asdrubalfuentes/ayModbusConverter/hardware/netlist.csv

Red | Nodos
+5V | J2.12 / U1.3 / C1.1 / C3.1 / U2.8
+VIN | J1.3 / U1.1 / C2.1
GND | J1.4 / J2.2 / J2.9 / J2.11 / J3.1 / J3.10 / U1.2 / C2.2 / C1.2 / C3.2 / U2.5 / R3.2 / D1.2
LED_A | R4.2 / D1.1
LED_D | J3.2 / R4.1
P1_DE | J2.6 / U2.2 / U2.3
P1_DI | J2.8 / U2.4
P1_RO | J2.7 / R2.2 / R3.1
RO_RAW | U2.1 / R2.1
RS485_A | J1.1 / U2.6 / R1.2
RS485_B | J1.2 / U2.7 / R1.1
