asdrubalfuentes/ayModbusConverter/hardware/enclosure/pieza1_chasis_desarrollo.dxf

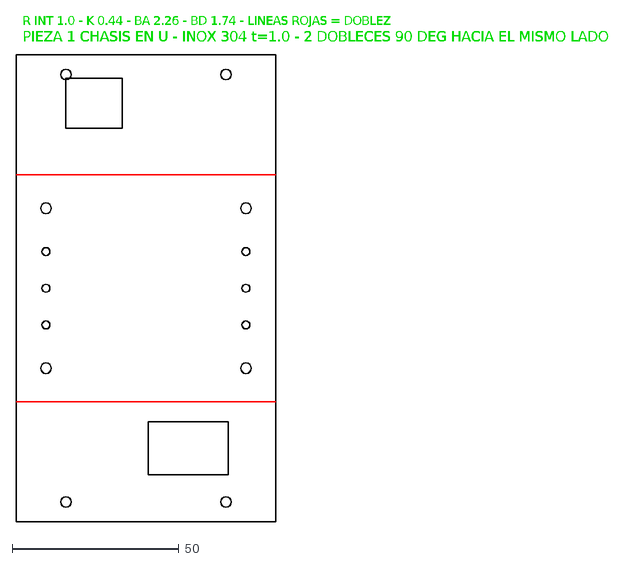
[picture p3: CAD file, 2026-11-12]
hardware/enclosure/pieza1_chasis_desarrollo.dxf
PIEZA 1 CHASIS EN U - INOX 304 t=1.0 - 2 DOBLECES 90 DEG HACIA EL MISMO LADO
R INT 1.0 - K 0.44 - BA 2.26 - BD 1.74 - LINEAS ROJAS = DOBLEZ
