asdrubalfuentes/ayModbusConverter/hardware/enclosure/pieza2_tapa_desarrollo.dxf

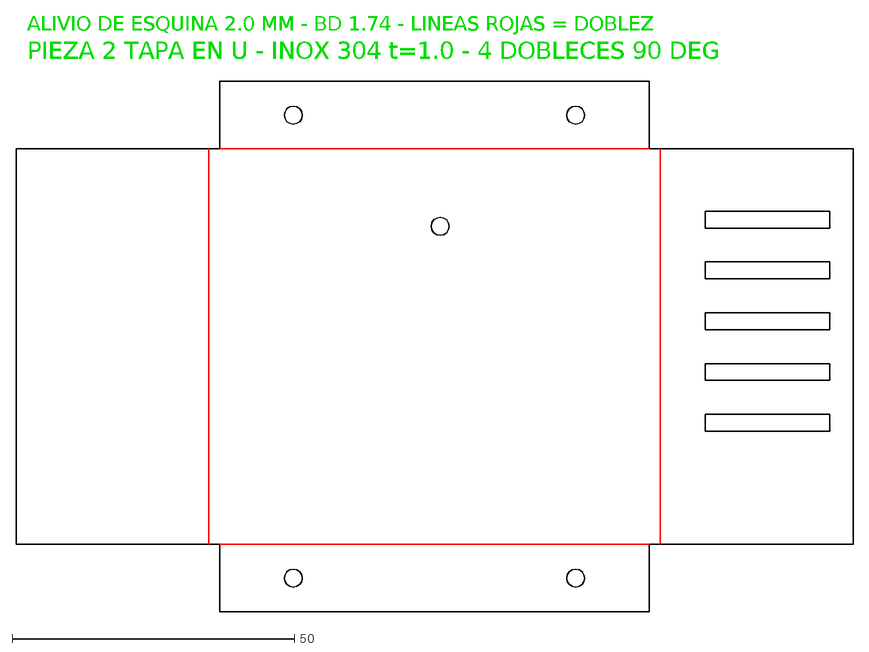
[picture p4: CAD file, 2026-11-12]
hardware/enclosure/pieza2_tapa_desarrollo.dxf
PIEZA 2 TAPA EN U - INOX 304 t=1.0 - 4 DOBLECES 90 DEG
ALIVIO DE ESQUINA 2.0 MM - BD 1.74 - LINEAS ROJAS = DOBLEZ
