asdrubalfuentes/ayModbusConverter/hardware/aymc_carrier_min.kicad_pcb

## KiCad design hardware/aymc_carrier_min.kicad_pcb (2026-11-12)

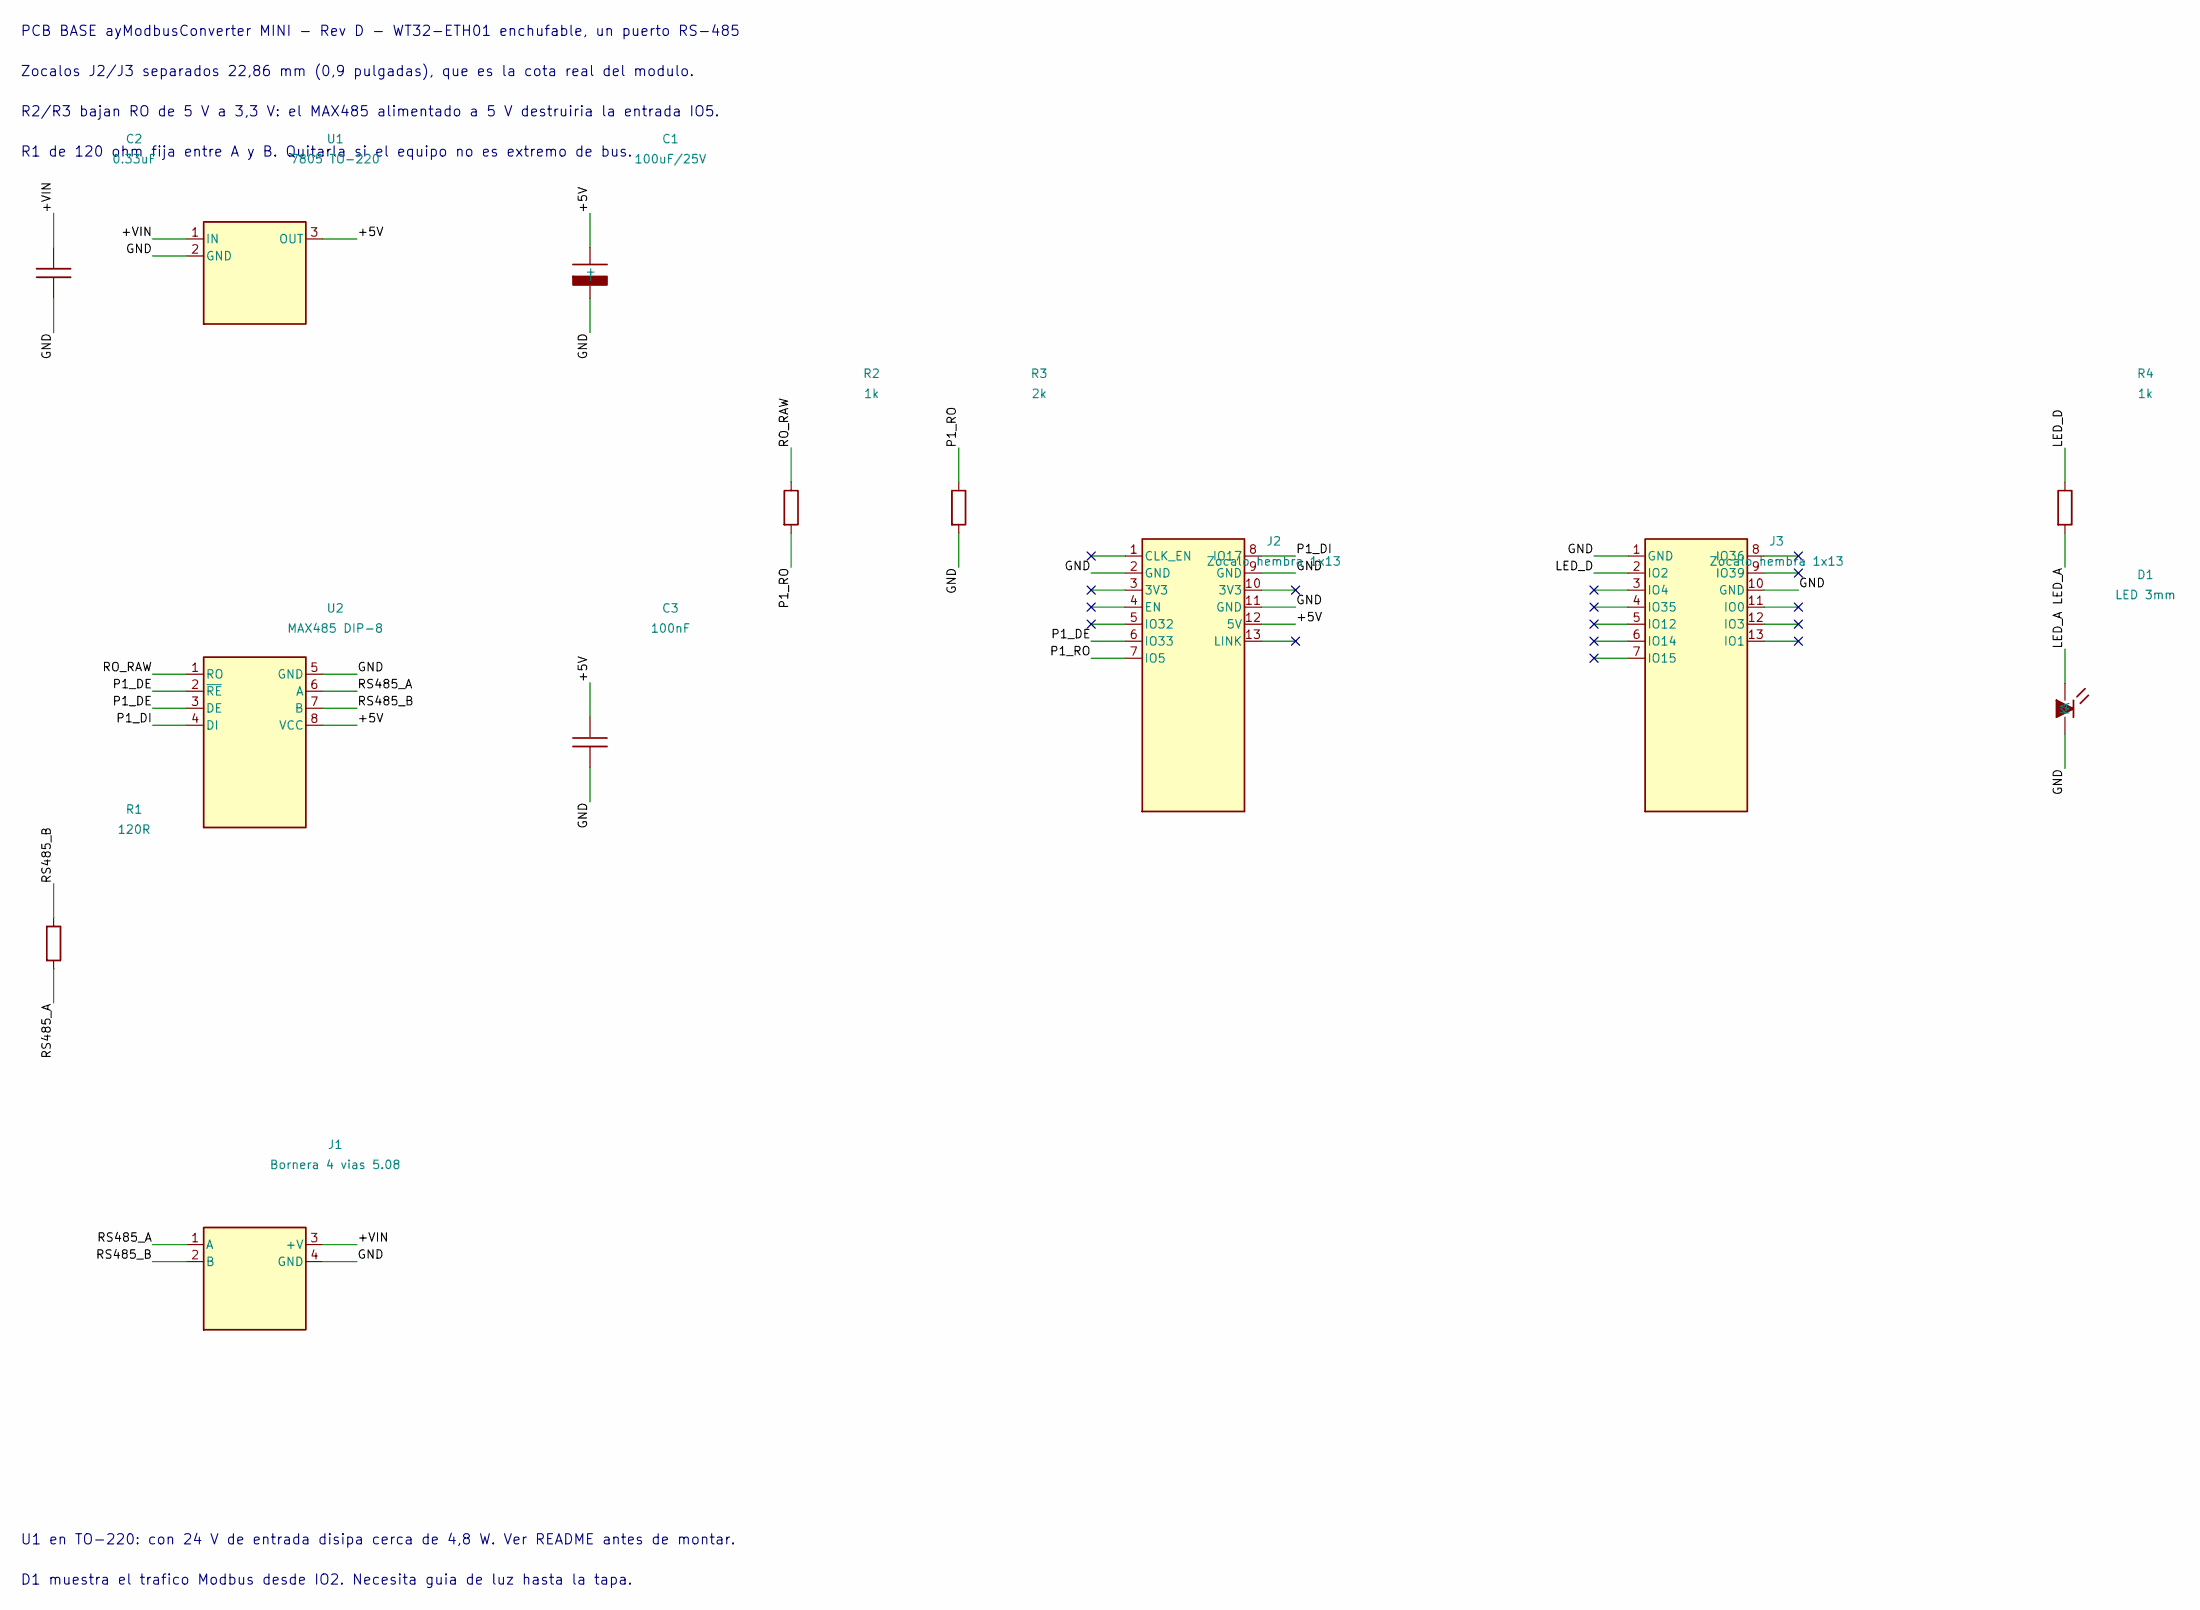
[picture p5: schematic aymc_carrier_min.kicad_sch, PCB base ayModbusConverter MINI]

Parts:
C1: 100uF/25V
C2: 0.33uF
C3: 100nF
D1: LED 3mm
J1: Bornera 4 vias 5.08
J2, J3: Zocalo hembra 1x13
R1: 120R
R2, R4: 1k
R3: 2k
U1: 7805 TO-220
U2: MAX485 DIP-8

Connections:
+5V: C1.1 (+), C3.1, J2.12 (5V), U1.3 (OUT), U2.8 (VCC)
+VIN: C2.1, J1.3 (+V), U1.1 (IN)
GND: C1.2 (-), C2.2, C3.2, D1.2 (K), J1.4 (GND), J2.2 (GND), J2.9 (GND), J2.11 (GND), J3.1 (GND), J3.10 (GND), R3.2, U1.2 (GND), U2.5 (GND)
LED_A: D1.1 (A), R4.2
LED_D: J3.2 (IO2), R4.1
P1_DE: J2.6 (IO33), U2.2 (~RE), U2.3 (DE)
P1_DI: J2.8 (IO17), U2.4 (DI)
P1_RO: J2.7 (IO5), R2.2, R3.1
RO_RAW: R2.1, U2.1 (RO)
RS485_A: J1.1 (A), R1.2, U2.6 (A)
RS485_B: J1.2 (B), R1.1, U2.7 (B)

Notes on the sheet:
PCB BASE ayModbusConverter MINI - Rev D - WT32-ETH01 enchufable, un puerto RS-485
Zocalos J2/J3 separados 22,86 mm (0,9 pulgadas), que es la cota real del modulo.
R2/R3 bajan RO de 5 V a 3,3 V: el MAX485 alimentado a 5 V destruiria la entrada IO5.
R1 de 120 ohm fija entre A y B. Quitarla si el equipo no es extremo de bus.
U1 en TO-220: con 24 V de entrada disipa cerca de 4,8 W. Ver README antes de montar.
D1 muestra el trafico Modbus desde IO2. Necesita guia de luz hasta la tapa.

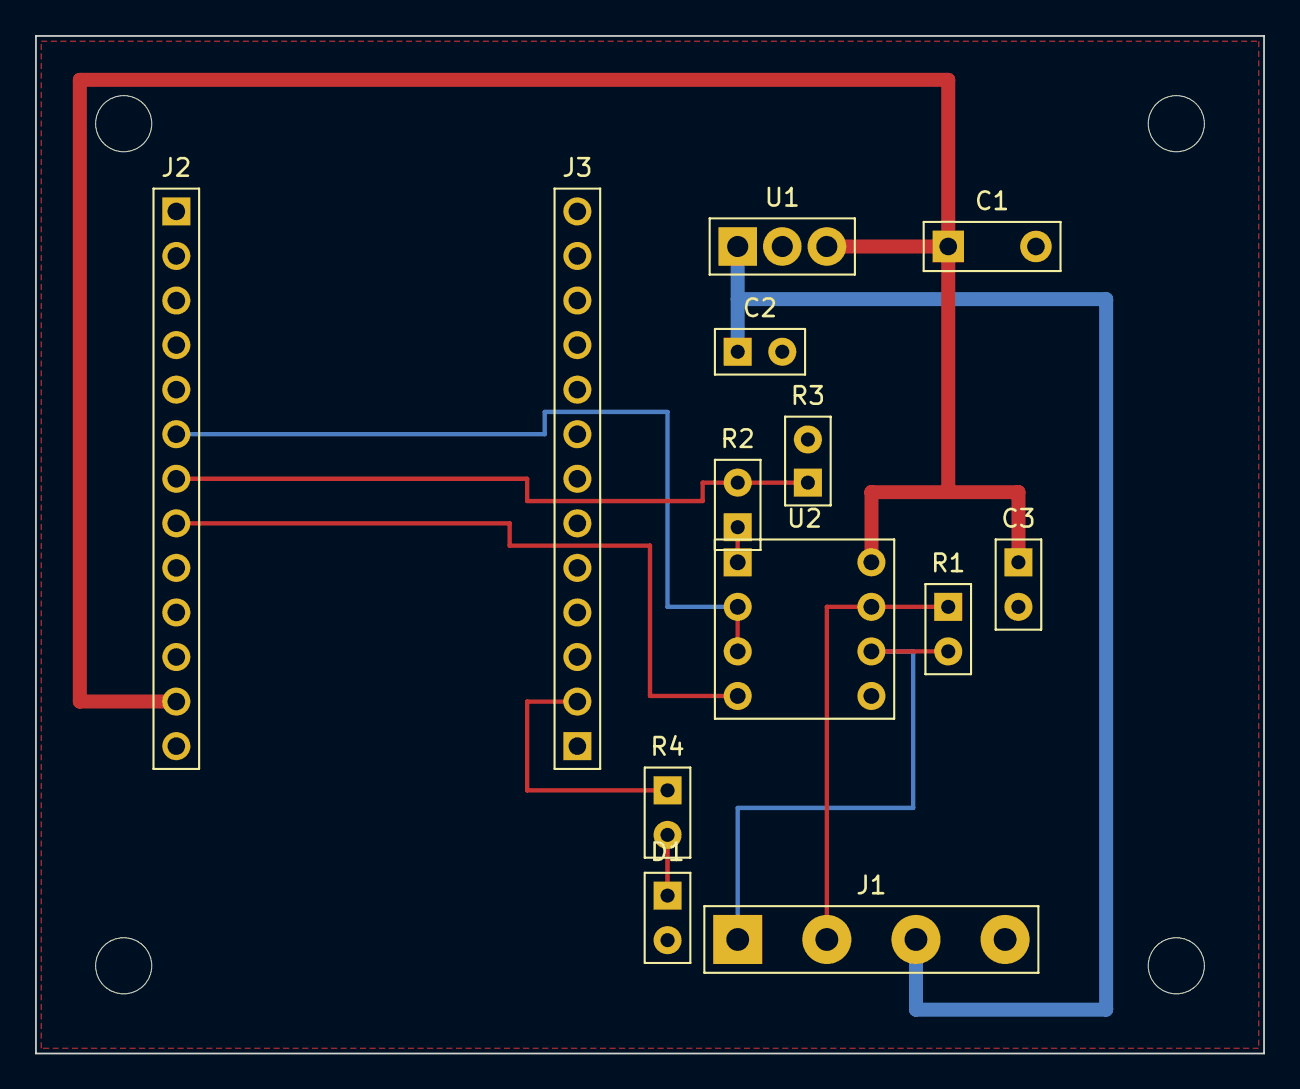
[picture p6: board aymc_carrier_min.kicad_pcb from above]

Board: 2 copper layers, 70.0 x 58.0 mm, 13 parts (0 on the bottom side), 11 nets.
