asdrubalfuentes/ayModbusConverter/(commit log)

2026-09-28 ayModbusConverter 1.0.0: conversor Modbus TCP <-> RTU sobre WT32-ETH01
    Servidor Modbus TCP transparente hacia el bus RS-485, LAN con DHCP/IP fija,
    WiFi solo como AP con portal cautivo, web de configuracion y diagnostico,
    OLED 128x64, OTA web y desde GitHub Releases.
2026-09-28 Banco de pruebas: simulador de esclavos RTU y bateria automatica
    - test/tools/rtu_slave_sim.py: esclavos Modbus RTU multi-ID con datos
    deterministas y retardo configurable por esclavo.
    - test/tools/gw_test.py: 18 pruebas de extremo a extremo por Modbus TCP
    (funciones, excepciones, TID/UID, encadenadas, fragmentadas, broadcast,
    concurrencia, limite de conexiones, latencia, API) y modo --soak.
    - test/README.md: materiales, cableado pin a pin, ambientes y checklist.
2026-09-28 v1.1.0: mejoras Aysafi (2 puertos, estados, asistente, cache, MQTT/REST)
    - Segundo puerto serie (RS-232 / RS-485 autodireccional) enrutado por Unit ID
    con rango y offset por puerto; broadcast a todos los puertos.
    - Nucleo con una tarea y una cola por puerto; la tarea TCP no se bloquea.
    - Estados de transmision OK / FALLAS / DESCONECTADO / SIN TRAFICO por puerto,
    esclavo y global (+ LAN DESCONECTADA) en OLED, portal y MQTT.
    - Esclavos caidos: 0x0B inmediato y reintento en segundo plano.
    - Asistente de puesta en marcha, deteccion automatica de baudios/paridad
    (activa y pasiva) y exploracion de equipos (FC43 + rangos).
    - Modo cache/agente con tabla de sondeo, aprendizaje del polling y reg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
2026-11-12 hardware: portadora MINI (WT32-ETH01 + MAX485) y carcasa inox
    Variante de un solo puerto: RS-485 por MAX485 no aislado y la LAN del
    modulo. Sin OLED, sin RS-232 y sin tramo optico. Configuracion por
    consola serie y por el AP WiFi con portal cautivo.
    El PCB es una base para la tarjeta de desarrollo: la WT32-ETH01 se
    enchufa en dos zocalos de 13 posiciones, no se suelda. Hacia el exterior
    solo hay dos borneras, J1 de 24 VDC y J2 de RS-485 A/B/GND.
    Esquematico (KiCad 8)
    - Pinaje del modulo con la numeracion fisica real de 26 pines (2x13),
    contrastada con el datasheet V1.4 y con la referencia egnor/wt32-eth01.
    El simbolo anterior usaba numeracion inventada de 20 pines.
    - GPIO verificados a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
    [aymc_carrier_min.kicad_sch, bom.csv, clip_din35.scad, netlist.csv, pieza1_chasis_desarrollo.dxf, pieza2_tapa_desarrollo.dxf]
2026-11-12 hardware: anclaje DIN comercial en vez de clip impreso
    El anclaje es un adaptador DIN verde que ya esta en uso, con tres agujeros
    M2 a 11 mm entre centros. El chasis pasa a llevar ese patron en lugar de
    los cuatro M3 que suponia un clip impreso.
    - Seis taladros de 2,4 mm en el dorso: dos clips separados 60 mm, tres
    agujeros cada uno a 11 mm de paso, con el clip en vertical para que
    cruce el riel.
    - clip_din35.scad queda como repuesto imprimible, no como copia del
    adaptador comercial.
    - README con las cotas medidas sobre las fotos y marcadas como estimadas,
    separadas del paso de 11 mm, que es dato firme.
    Claude-Session: https://c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
    [pieza1_chasis_desarrollo.dxf]
2026-11-12 hardware: corrige el script de Fusion y lo verifica contra el modelo
    Ejecutado en Fusion sobre el equipo del usuario. Tres fallos reales:
    - root.name no se puede asignar desde la API (RuntimeError 3). Se quita.
    - Los cortes necesitan participantBodies explicito; sin el, Fusion
    responde "no se ha encontrado ningun cuerpo de destino".
    - Los arcos del perfil en U barrian en sentido antihorario, asi que el
    contorno no cerraba y la extrusion producia una tira plana de 1 mm en
    vez del canal. Barrido corregido a -pi/2 y seleccion del perfil de
    mayor area en vez de profiles.item(0).
    El script escribe ahora hardware/enclosure/reporte.txt con la caja
    envolvente, el volumen y el area de cada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
2026-11-12 hardware: ensamble de orientacion respecto al riel DIN
    Script de Fusion que monta riel TS35, los dos anclajes, el chasis, los
    separadores, el PCB con su modulo y borneras, y la tornilleria, cada uno
    en su posicion. Sirve para fijar la orientacion antes de rutear el PCB.
    Ejes: +X profundidad hacia el operador, +Y vertical, +Z a lo largo del
    riel. El dorso del chasis queda en X = -1 y el riel detras, en X negativo.
    Un fallo real que salio al ejecutarlo: en un plano desplazado del YZ el
    eje local X apunta a +Z global, no a +Y. Los cilindros de tornillos y
    separadores se creaban con Y y Z intercambiados, y la tornilleria salia
    en Y +-32 / Z +-13 en vez de Y +-13 / Z +-32. Corregido, y el scrip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
2026-11-12 hardware: PCB base ruteado, un puerto RS-485 y bornera unica
    Rediseno segun la descripcion de la placa base: una sola bornera de 4
    terminales atornillables (A, B, +V 9-24 Vdc, GND), dos zocalos de 13
    pines para enchufar el WT32-ETH01, 7805, MAX485, terminacion de 120 ohm
    y LED de enlace Modbus. Nada mas.
    El modulo gira 90 grados respecto al diseno anterior: eje largo vertical,
    para que el RJ45 salga por la pared superior del chasis y la bornera por
    la inferior. Asi todas las aberturas quedan en el chasis y la tapa solo
    necesita el agujero del LED.
    Tres desviaciones respecto a lo pedido, todas documentadas en el README:
    - Zocalos a 22,86 mm y no a 24. Es la cota real del modulo (0,9"), y 2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
    [aymc_carrier_min.kicad_pcb, aymc_carrier_min.kicad_sch, bom.csv, netlist.csv]
2026-11-12 hardware: reduce placa y carcasa al minimo practico
    Placa de 70 x 58 mm (antes 95 x 72) y caja de 78 x 68 x 36 interior
    (antes 104 x 82 x 40).
    PCB 6840 -> 4060 mm2 -41 %
    Volumen de caja 341 -> 191 cm3 -44 %
    Chapa bruta 366 -> 249 cm2 -32 %
    Masa de inox 289 -> 197 g -32 %
    Que permitio apretarla:
    - MAX485, divisor y terminacion agrupados en la columna derecha junto a
    la bornera, en vez de repartidos por la placa.
    - Taladros de fijacion a 5 mm del borde y la alimentacion cruzando por
    el borde superior, a 2,5 mm.
    - Pista de senal a 0,25 mm, lo justo para pasar entre pads a paso 2,54
    con 0,2 mm de holgura. Alimentacion a 0,8 mm.
    El limit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
    [aymc_carrier_min.kicad_pcb, aymc_carrier_min.kicad_sch, bom.csv, pieza1_chasis_desarrollo.dxf, pieza2_tapa_desarrollo.dxf]
